TheClumsyRaccoon/LePetitPrince/RAPPORTS_DE_SEANCES/GUILLAUME/02_GUILLAUME.pdf

Rapport de séance | 11/11/2026

BERNARD Guillaume
J’ai commencé cette séance par de la modélisation 3D afin de nous permettre de réutiliser la tête du piston de la seringue (déjà étanche et adapté au système) et ainsi nous éviter tout problèmes d’étanchéité du ballast. Ainsi j’ai modélisé et testé un composant effectuant la jonction écrou trapézoïdal - piston (figure 1) (qui rend le piston modélisé durant la dernière séance obsolète).
On a ainsi une forme en pyramide reproduisant fidèlement la jonction du piston - piston déjà présent sur la seringue, et de l'autre côté un espace permettant l’ajout d’insert fileté M3 afin de fixer l’écrou.

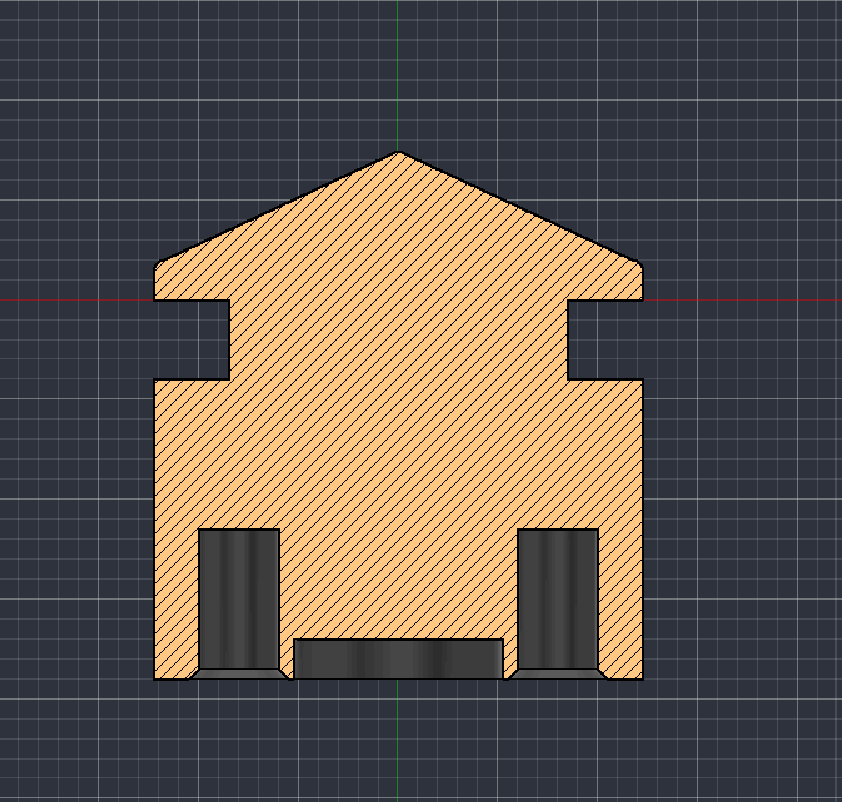
[picture p1: figure]
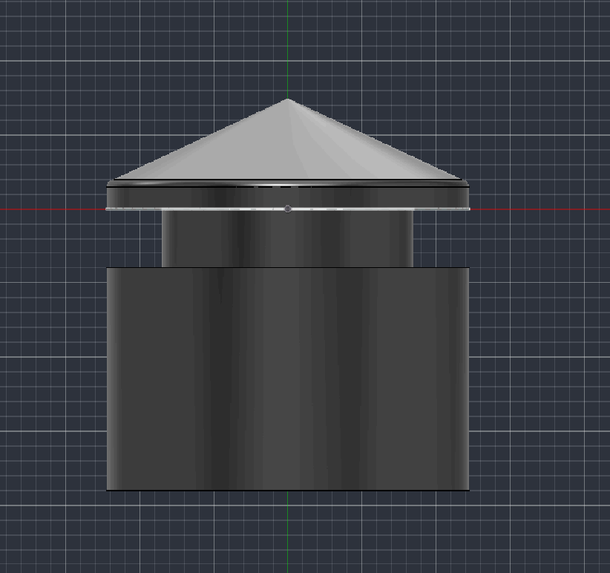
[picture p2: figure]

Figure 1. Captures d’écran en vue de profil et de coupe de la pièce 1

J’ai ensuite modélisé des silent-blocks (figure 2) qui permettent un amortissement des vibrations pour la structure caméra + IMU. Ils seront imprimés en TPU mais n’ont pas encore été testés durant la séance.
On viendra tarauder les trous directement avec la vis permettant une fixation stable.

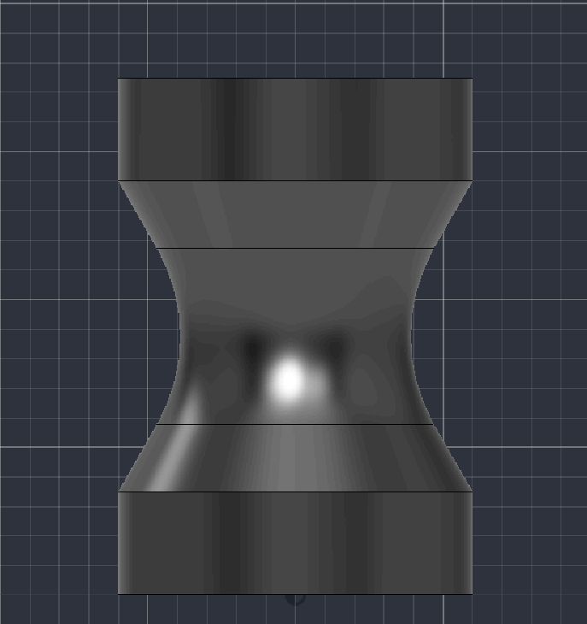
[picture p3: figure]
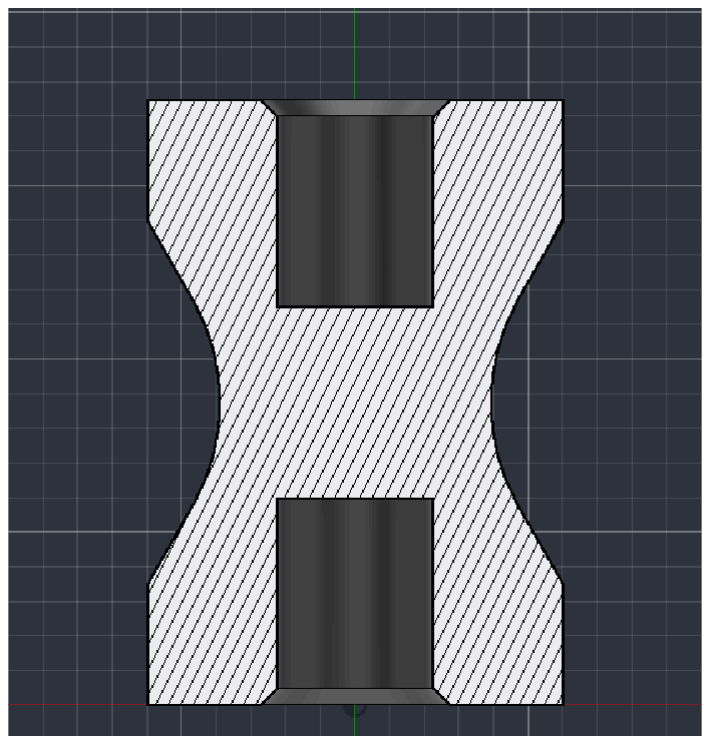
[picture p4: figure]

Figure 2. Captures d’écran en vue de profil et de coupe de la pièce 2
