TheClumsyRaccoon/LePetitPrince/RAPPORTS_DE_SEANCES/BENOIT/02_BENOIT.pdf

Compte rendu de séance de robotique

Lors de cette séance, j'ai principalement travaillé sur la préparation et la vérification des différents composants électroniques du robot.

J'ai commencé par souder les headers sur mes différents composants afin de pouvoir les intégrer plus facilement au montage. J'ai également aidé plusieurs camarades à souder des composants.

J'ai ensuite vérifié les adresses I2C de l'ensemble de mes composants afin d'identifier les éventuels conflits d'adresses. Lorsque plusieurs composants possédaient la même adresse, j'ai soudé les jumpers correspondants pour modifier leur configuration et éviter les doublons sur le bus I2C.

J'ai également effectué des tests sur les capteurs de pression et de température afin de vérifier leur bon fonctionnement et de m'assurer que les mesures obtenues étaient cohérentes.

Enfin, j'ai ajouté plusieurs programmes de test et de visualisation au projet (cf github) :

- test_imu : programme de test de l'IMU, qui reste à vérifier lorsque le composant sera disponible.
- visu_imu : programme destiné à visualiser les données de l'IMU.
- test_lecture_bmp280 : programme de test du capteur BMP280.
- test_lecture_ms5837 : programme de test du capteur MS5837.

Cette séance a donc permis d'avancer sur la préparation matérielle des composants, de vérifier le fonctionnement de plusieurs capteurs et de préparer les premiers outils logiciels nécessaires à leur intégration dans le robot.
