TheClumsyRaccoon/LePetitPrince/(list of files, cad)

Other CAD files:
Hardware/Bouchon de guidage.f3z
