TheClumsyRaccoon/LePetitPrince/(commit log)

2026-11-10 Ajout adresse I2C
2026-11-10 Ajout adresses I2C
2026-11-10 Modif adresse I2C
2026-11-10 Ajout visualisation IMU
2026-11-11 AJOUT rapport de séance Benoît
